vrees/woobeamlamp/kicad/pictures/woodbeamlamp_3D.PNG

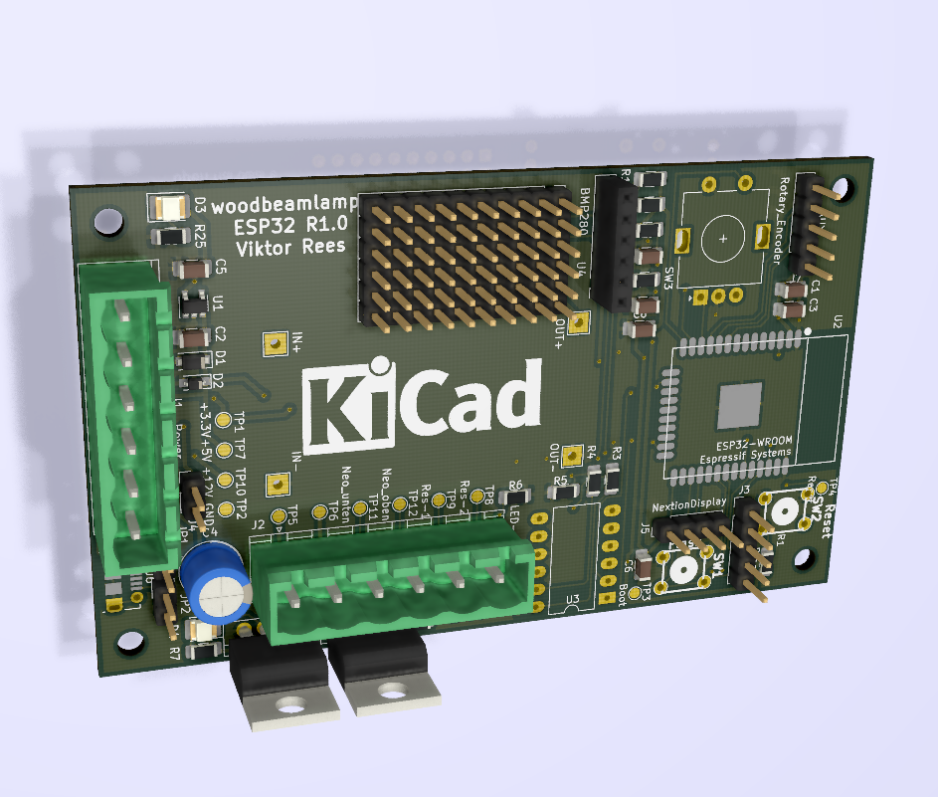
kicad/pictures/woodbeamlamp_3D.PNG
