vrees/woobeamlamp/README.md

# woobeamlamp
ESP32 application to control the LEDs of the wood beam lamp
