vrees/woobeamlamp/kicad/bom.ods

Item | Status | Qty | Reference(s) | Value | LibPart | Footprint | Datasheet
1 | X | 3 | C1, C7, C9 | 1u | Device:C | Capacitor_SMD:C_1206_3216Metric_Pad1.42x1.75mm_HandSolder | ~
2 | X | 2 | C2, C5 | 10u | Device:C | Capacitor_SMD:C_1206_3216Metric_Pad1.42x1.75mm_HandSolder | ~
3 | X | 3 | C3, C6, C8 | 100n | Device:C | Capacitor_SMD:C_1206_3216Metric_Pad1.42x1.75mm_HandSolder | ~
4 | X | 1 | C4 | 100uF | Device:CP_Small | Capacitor_THT:CP_Radial_D7.5mm_P2.50mm | ~
5 |  | 1 | D1 | MMSZ5V6CF | Device:D_Zener | Diode_SMD:D_SOD-123F | http://www.onsemi.com/pub/Collateral/MMSZ36VCF-D.pdf
6 |  | 1 | D2 | ESDZL5-1F4 | Device:D_TVS | Diode_SMD:D_SOD-323_HandSoldering | https://www.st.com/resource/en/datasheet/esdzl5-1f4.pdf
7 | X | 3 | D3, D4, D5 | LED | Device:LED | LED_SMD:LED_1210_3225Metric_Pad1.42x2.65mm_HandSolder | ~
8 | X | 1 | J1 | Power | Connector:Screw_Terminal_01x06 | Connector_Phoenix_MSTB:PhoenixContact_MSTBVA_2,5_6-G-5,08_1x06_P5.08mm_Vertical | ~
9 | X | 1 | J2 | LED-out | Connector:Screw_Terminal_01x06 | Connector_Phoenix_MSTB:PhoenixContact_MSTBVA_2,5_6-G-5,08_1x06_P5.08mm_Vertical | ~
10 | X | 1 | J3 | Prog | Connector:Conn_01x05_Male | Connector_PinHeader_2.54mm:PinHeader_1x05_P2.54mm_Vertical | ~
11 | X | 1 | J4 | 3.3V | Connector_Generic:Conn_01x02 | Connector_PinHeader_2.54mm:PinHeader_1x02_P2.54mm_Vertical | ~
12 | X | 1 | J5 | NextionDisplay | Connector:Conn_01x04_Male | Connector_PinHeader_2.54mm:PinHeader_1x04_P2.54mm_Vertical | ~
13 | X | 1 | J6 | USB_B_Micro | Connector:USB_B_Micro | Connector_USB:USB_Micro-B_Molex-105017-0001 | ~
14 | X | 1 | J7 | AUX | Connector:Conn_01x05_Male | Connector_PinHeader_2.54mm:PinHeader_1x05_P2.54mm_Vertical | ~
15 | X | 1 | JP1 | USB-5V | Device:Jumper_NO_Small | Connector_PinHeader_2.54mm:PinHeader_1x02_P2.54mm_Vertical | ~
16 | X | 1 | JP2 | USB-GND | Device:Jumper_NO_Small | Connector_PinHeader_2.54mm:PinHeader_1x02_P2.54mm_Vertical | ~
17 | X | 2 | Q1, Q2 | IRF3708 | Transistor_FET:IRLZ44N | Package_TO_SOT_THT:TO-220-3_Vertical | ~
18 | X | 3 | R1, R10, R12 | 10k | Device:R | Resistor_SMD:R_1206_3216Metric_Pad1.42x1.75mm_HandSolder | ~
19 | X | 2 | R2, R13 | 100k | Device:R | Resistor_SMD:R_1206_3216Metric_Pad1.42x1.75mm_HandSolder | ~
20 | X | 3 | R3, R4, R25 | 220R | Device:R | Resistor_SMD:R_1206_3216Metric_Pad1.42x1.75mm_HandSolder | ~
21 | X | 2 | R5, R6 | 100k | Device:R | Resistor_SMD:R_1206_3216Metric_Pad1.42x1.75mm_HandSolder | ~
22 | X | 2 | R7, R8 | 680R | Device:R | Resistor_SMD:R_1206_3216Metric_Pad1.42x1.75mm_HandSolder | ~
23 | X | 2 | R9, R11 | 10k | Device:R | Resistor_SMD:R_1206_3216Metric_Pad1.42x1.75mm_HandSolder | ~
24 | X | 1 | SW1 | Flash | Switch:SW_Push_Dual | w_switch:PCB_PUSH
25 | X | 1 | SW2 | Reset | Switch:SW_Push_Dual | w_switch:PCB_PUSH
26 | X | 1 | SW3 | Rotary_Encoder | Device:Rotary_Encoder_Switch | Rotary_Encoder:RotaryEncoder_Alps_EC11E-Switch_Vertical_H20mm | ~
27 | X | 1 | U1 | TLV70233 | Regulator_Linear:TLV70233_SOT23-5 | Package_TO_SOT_SMD:SOT-23-5 | http://www.ti.com/lit/ds/symlink/tlv712.pdf
28 | X | 1 | U2 | ESP-WROOM-32 | ESP32-wroom:ESP-WROOM-32-module | ESP32-footprints:ESP32-WROOM | https://www.espressif.com/sites/default/files/documentation/esp32_datasheet_en.pdf
29 | X | 1 | U3 | LevelShifter | Level_Shifter_4x:LevelShifter | Package_DIP:DIP-12_W10.16mm_LongPads
30 | X | 1 | U4 | BMP280 | BMP280:BMP280 | Connector_PinSocket_2.54mm:PinSocket_1x06_P2.54mm_Vertical
