vrees/woobeamlamp/kicad/ESP32-wood-beam-lamp.pdf

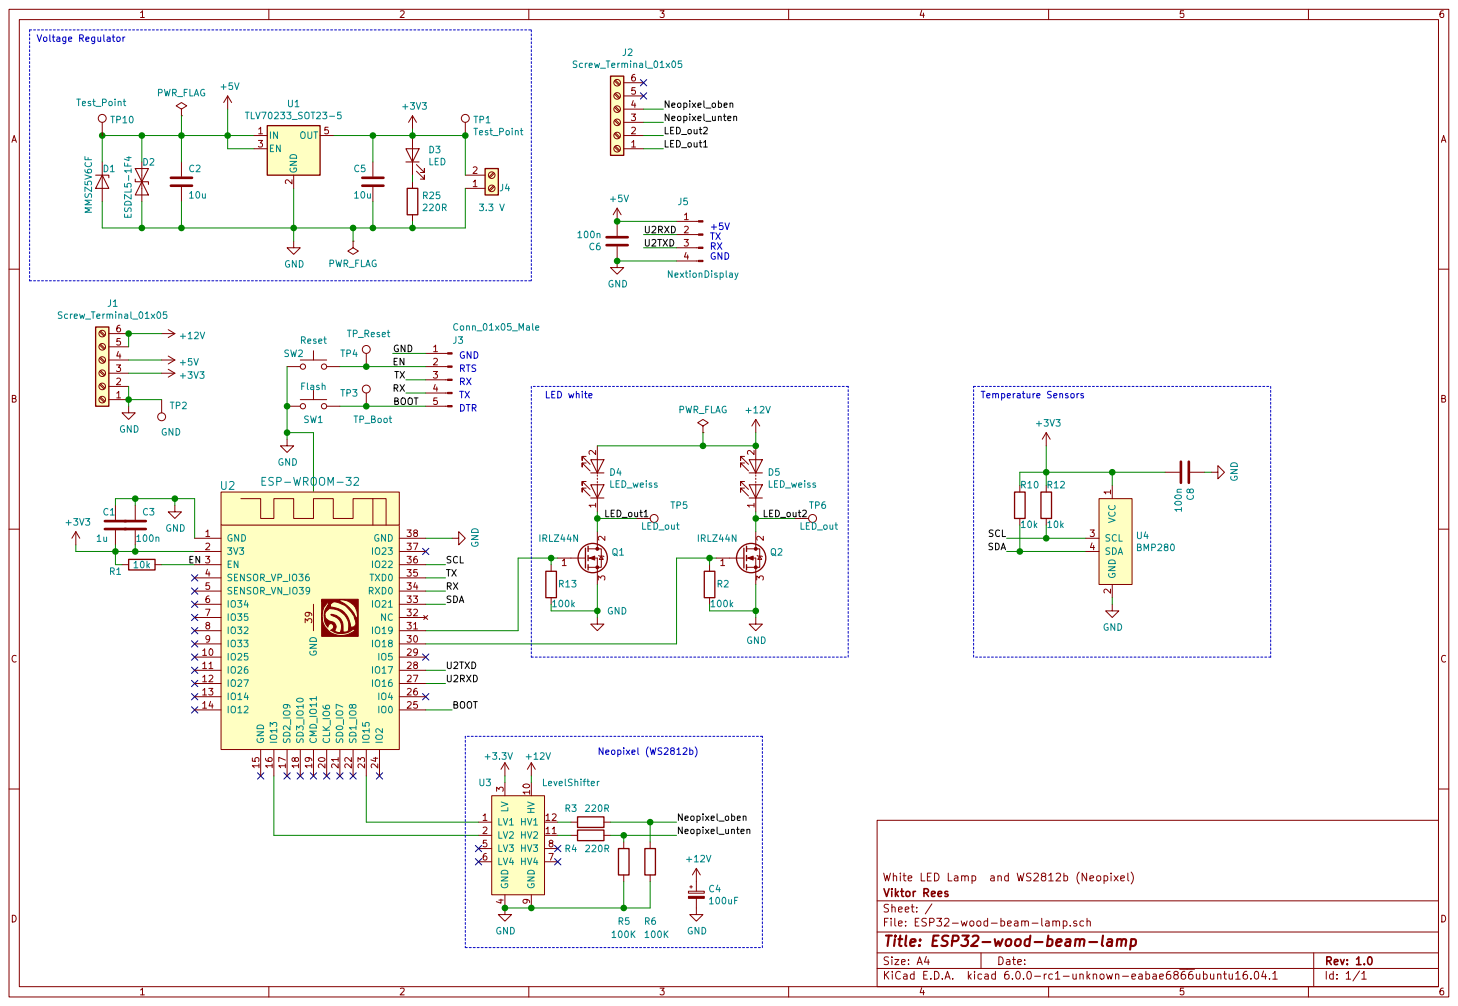
[picture p2: page 1]

File: ESP32-wood-beam-lamp.sch Sheet: / Viktor Rees White LED Lamp and WS2812b (Neopixel)

Id: 1/1 Title: ESP32-wood-beam-lamp
