vrees/woobeamlamp/kicad/pictures/ESP32-wood-beam-lamp.pdf

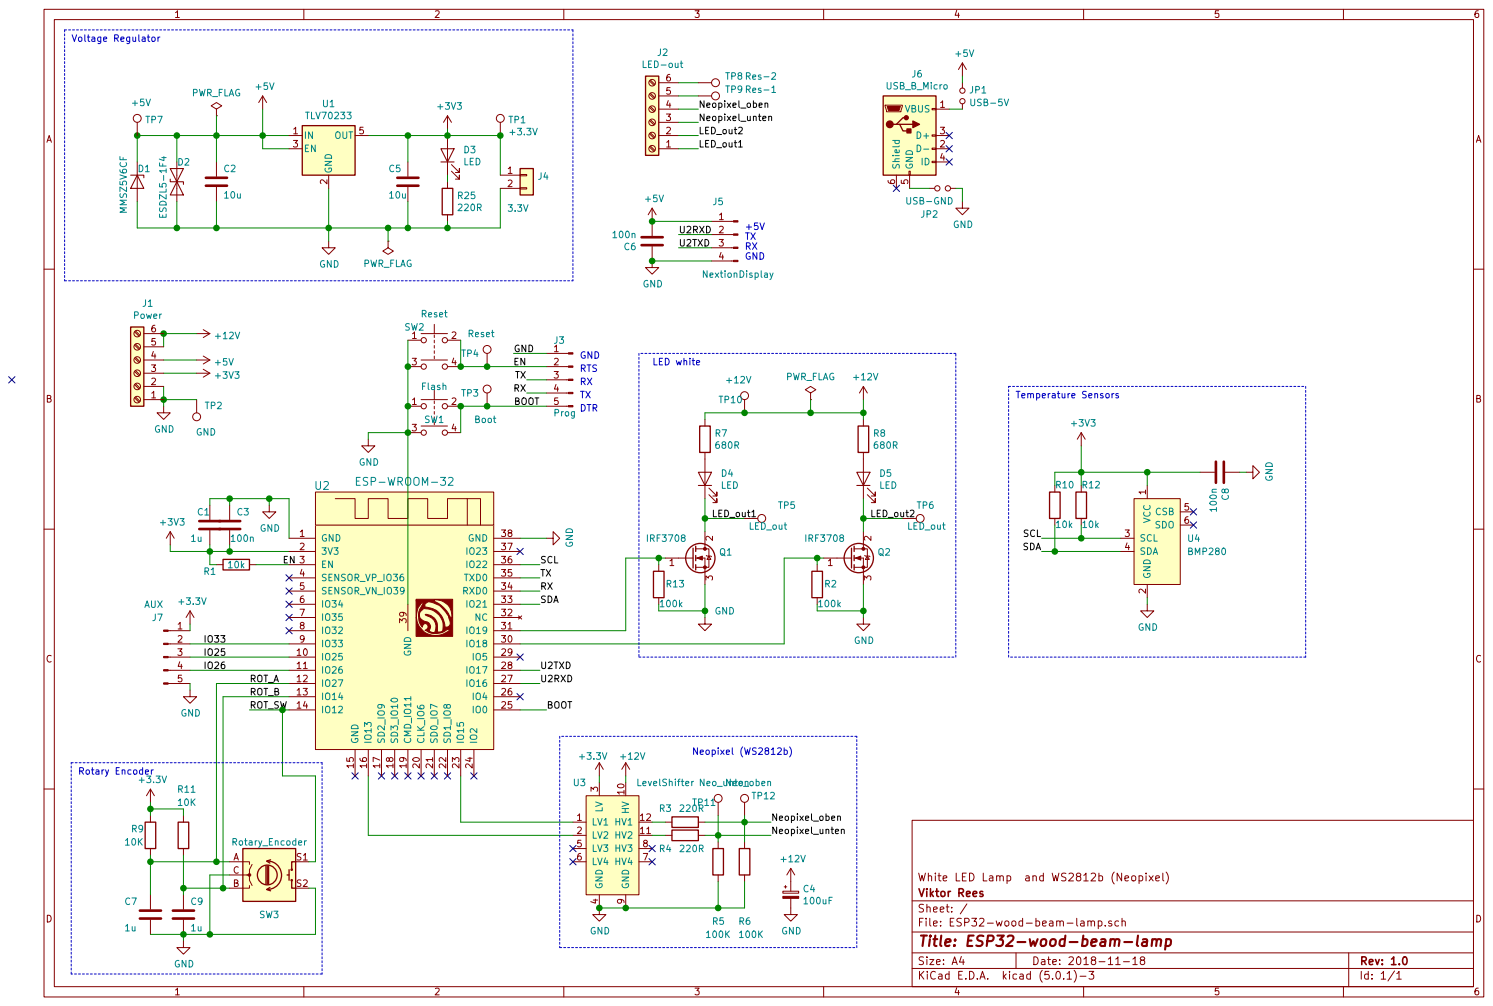
[picture p3: page 1]

2 SCL 3 SDA 4 CSB 5 SDO 6U4BMP280

File: ESP32-wood-beam-lamp.sch Sheet: / Viktor Rees White LED Lamp and WS2812b (Neopixel)

Id: 1/1 Title: ESP32-wood-beam-lamp
