vrees/woobeamlamp/kicad/ESP32-wood-beam-lamp.kicad_pcb

## KiCad design kicad/ESP32-wood-beam-lamp.kicad_pcb (2018-12-24)

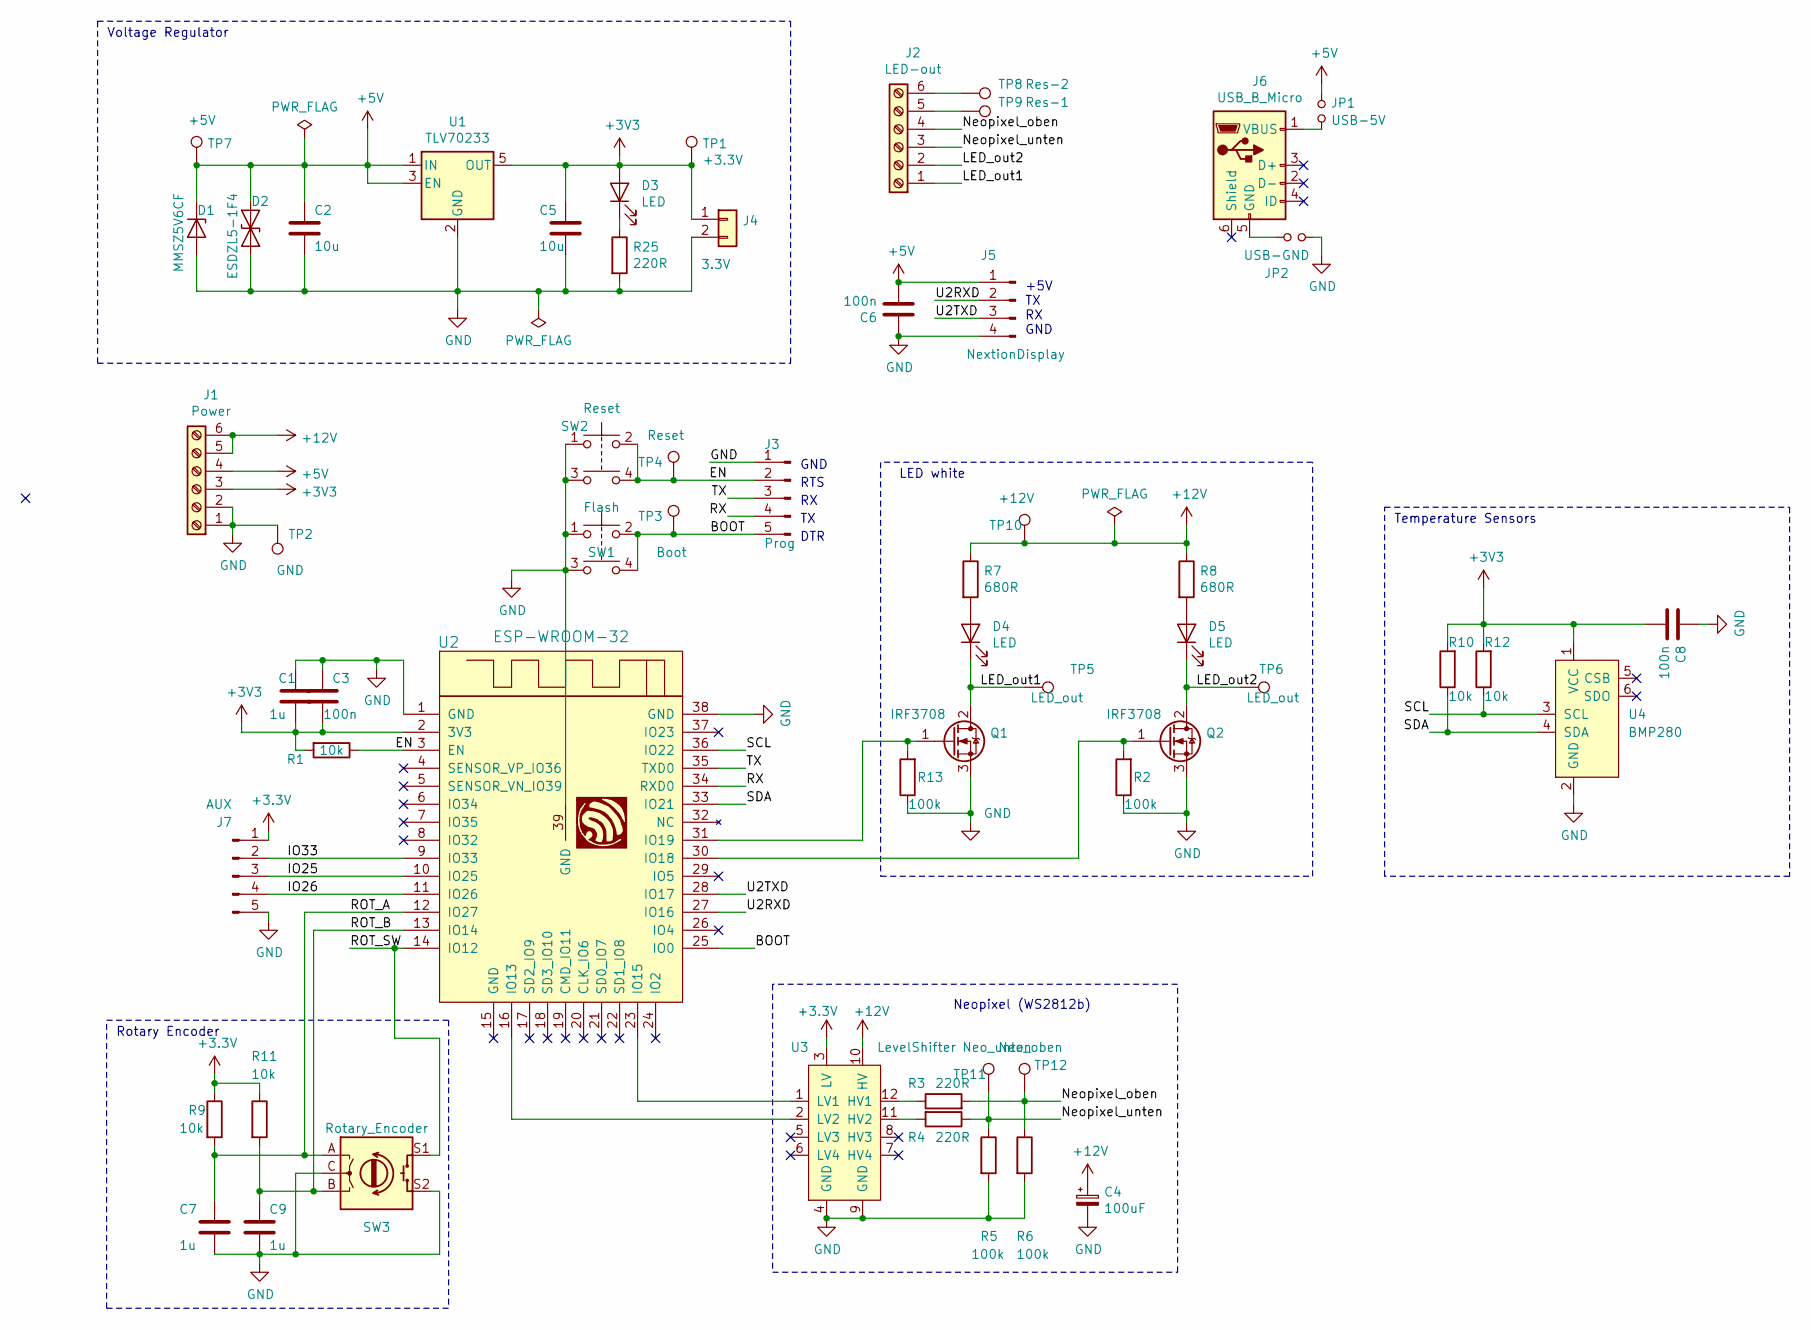
[picture p4: schematic ESP32-wood-beam-lamp.sch]

Parts:
C1, C7, C9: 1u; C_1206_3216Metric_Pad1.42x1.75mm_HandSolder
C2, C5: 10u; C_1206_3216Metric_Pad1.42x1.75mm_HandSolder
C3, C6, C8: 100n; C_1206_3216Metric_Pad1.42x1.75mm_HandSolder
C4: 100uF; CP_Radial_D7.5mm_P2.50mm
D1: MMSZ5V6CF; D_SOD-123F
D2: ESDZL5-1F4; D_SOD-323_HandSoldering
D3, D4, D5: LED; LED_1210_3225Metric_Pad1.42x2.65mm_HandSolder
J1: Power; PhoenixContact_MSTBVA_2,5_6-G-5,08_1x06_P5.08mm_Vertical
J2: LED-out; PhoenixContact_MSTBVA_2,5_6-G-5,08_1x06_P5.08mm_Vertical
J3: Prog; PinHeader_1x05_P2.54mm_Vertical
J4: 3.3V; PinHeader_1x02_P2.54mm_Vertical
J5: NextionDisplay; PinHeader_1x04_P2.54mm_Vertical
J6: USB_B_Micro; USB_Micro-B_Molex-105017-0001
J7: AUX; PinHeader_1x05_P2.54mm_Vertical
JP1: USB-5V; PinHeader_1x02_P2.54mm_Vertical
JP2: USB-GND; PinHeader_1x02_P2.54mm_Vertical
Q1, Q2: IRF3708; TO-220-3_Vertical
R1, R9, R10, R11, R12: 10k; R_1206_3216Metric_Pad1.42x1.75mm_HandSolder
R2, R5, R6, R13: 100k; R_1206_3216Metric_Pad1.42x1.75mm_HandSolder
R3, R4, R25: 220R; R_1206_3216Metric_Pad1.42x1.75mm_HandSolder
R7, R8: 680R; R_1206_3216Metric_Pad1.42x1.75mm_HandSolder
SW1: Flash; PCB_PUSH
SW2: Reset; PCB_PUSH
SW3: Rotary_Encoder; RotaryEncoder_Alps_EC11E-Switch_Vertical_H20mm
TP1: +3.3V; TestPoint_Pad_D1.5mm
TP2: GND; TestPoint_Pad_D1.5mm
TP3: Boot; TestPoint_Pad_D1.5mm
TP4: Reset; TestPoint_Pad_D1.5mm
TP5, TP6: LED_out; TestPoint_Pad_D1.5mm
TP7: +5V; TestPoint_Pad_D1.5mm
TP8: Res-2; TestPoint_Pad_D1.5mm
TP9: Res-1; TestPoint_Pad_D1.5mm
TP10: +12V; TestPoint_Pad_D1.5mm
TP11: Neo_unten; TestPoint_Pad_D1.5mm
TP12: Neo_oben; TestPoint_Pad_D1.5mm
U1: TLV70233; SOT-23-5
U2: ESP-WROOM-32; ESP32-WROOM
U3: LevelShifter; DIP-12_W10.16mm_LongPads
U4: BMP280; PinSocket_1x06_P2.54mm_Vertical

Connections:
+5V: C2.1, C6.2, D1.1 (K), D2.1 (A1), J1.4, J5.1, JP1.1, TP7.1, U1.1 (IN), U1.3 (EN); also elsewhere on the board
+12V: C4.1, J1.5, J1.6, R7.1, R8.1, TP10.1, U3.10 (HV); also elsewhere on the board
/BOOT: J3.5, SW1.2, SW1.4, TP3.1, U2.25 (IO0)
/EN: J3.2, R1.1, SW2.2, SW2.4, TP4.1, U2.3 (EN)
/IO25: J7.3, U2.10 (IO25)
/IO26: J7.4, U2.11 (IO26)
/IO33: J7.2, U2.9 (IO33)
/LED_out1: D4.1 (K), J2.1, Q1.2 (D), TP5.1
/LED_out2: D5.1 (K), J2.2, Q2.2 (D), TP6.1
/Neopixel_oben: J2.4, R3.2, R6.1, TP12.1
/Neopixel_unten: J2.3, R4.1, R5.1, TP11.1
/ROT_A: C7.1, R9.2, SW3.A, U2.12 (IO27)
/ROT_B: C9.1, R11.2, SW3.B, U2.13 (IO14)
/ROT_SW: SW3.S1, U2.14 (IO12)
/RX: J3.4, U2.34 (RXD0)
/SCL: R12.1, U2.36 (IO22), U4.3 (SCL)
/SDA: R10.1, U2.33 (IO21), U4.4 (SDA)
/TX: J3.3, U2.35 (TXD0)
/U2RXD: J5.2, U2.27 (IO16)
/U2TXD: J5.3, U2.28 (IO17)
GND: C1.1, C2.2, C3.1, C4.2, C5.2, C6.1, C7.2, C8.1, C9.2, D1.2 (A), D2.2 (A2), J1.1, J1.2, J3.1, J4.2, J5.4, J7.5, JP2.1, Q1.3 (S), Q2.3 (S), R2.1, R5.2, R6.2, R13.1, R25.2, SW1.1, SW1.3, SW2.1, SW2.3, SW3.C, SW3.S2, TP2.1, U1.2 (GND), U2.1 (GND), U2.38 (GND), U2.39 (GND), U3.4 (GND), U3.9 (GND), U4.2 (GND); also elsewhere on the board
unnamed: D3.1 (K), R25.1
unnamed: D4.2 (A), R7.2
unnamed: D5.2 (A), R8.2
unnamed: J2.5, TP9.1
unnamed: J2.6, TP8.1
unnamed: J6.1 (VBUS), JP1.2
unnamed: J6.5 (GND), JP2.2
unnamed: Q1.1 (G), R13.2, U2.31 (IO19)
unnamed: Q2.1 (G), R2.2, U2.30 (IO18)
unnamed: R3.1, U3.12 (HV1)
unnamed: R4.2, U3.11 (HV2)
unnamed: U2.16 (IO13), U3.2 (LV2)
unnamed: U2.23 (IO15), U3.1 (LV1)

Notes on the sheet:
Voltage Regulator
Temperature Sensors
DTR
RTS
GND
+5V TX RX GND
LED white
Neopixel (WS2812b)
Rotary Encoder

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
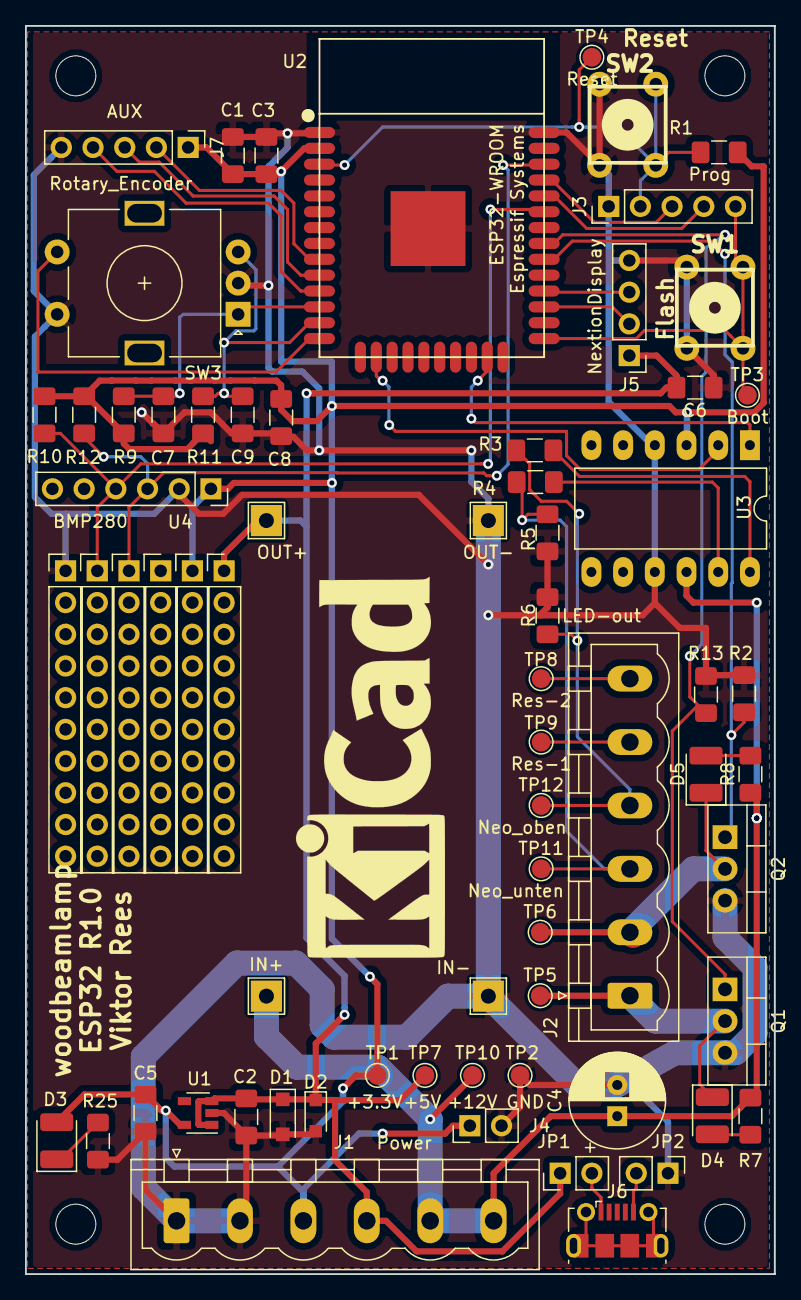
[picture p5: board ESP32-wood-beam-lamp.kicad_pcb from above]

Board: 2 copper layers, 60.0 x 100.0 mm, 62 parts (0 on the bottom side), 35 nets.

Other parts of the board:
IN+: +12V; TestPoint_THTPad_2.5x2.5mm_Drill1.2mm
IN-: GND; TestPoint_THTPad_2.5x2.5mm_Drill1.2mm
OUT+: +5v; TestPoint_THTPad_2.5x2.5mm_Drill1.2mm
OUT-: GND; TestPoint_THTPad_2.5x2.5mm_Drill1.2mm

Their connections:
+5V: OUT+.1; also elsewhere on the board
+12V: IN+.1; also elsewhere on the board
GND: IN-.1, OUT-.1; also elsewhere on the board
