vrees/woobeamlamp/(commit log)

2018-11-04 added BMP280
    [ESP32-wood-beam-lamp.sch]
2018-11-05 Nextion connector added
    [ESP32-wood-beam-lamp.sch]
2018-11-07 USB Connector added
    [ESP32-wood-beam-lamp.sch]
2018-11-11 footprints added
    [ESP32-wood-beam-lamp.sch]
2018-11-13 rotary Encoder added
    [ESP32-wood-beam-lamp.sch]
2018-11-14 ESP32 footprint added
    [ESP32-wood-beam-lamp.sch]
2018-12-30 encoder is done
2020-12-29 Obere weisse Leds funktionieren jetzt. WS2812 Leds ersetzt durch einfache weisse
